priyankan-v/Guitar-Headphone-Amplifier/1.jpg

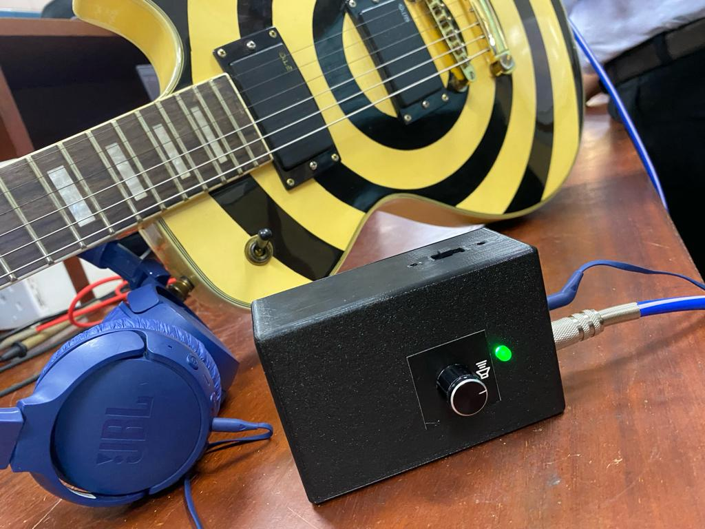
1.jpg
