priyankan-v/Guitar-Headphone-Amplifier/product.jpeg

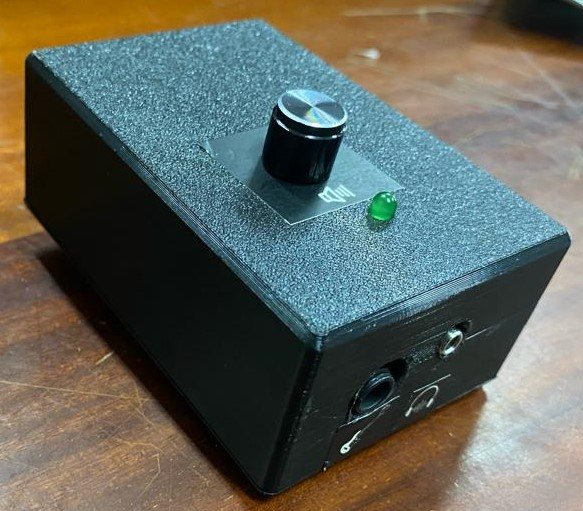
product.jpeg
