priyankan-v/Guitar-Headphone-Amplifier/README.md

# Guitar-Headphone-Amplifier
Designing a headphone amplifier with analog components
