priyankan-v/Guitar-Headphone-Amplifier/BoM.pdf

Comment | Description | Designator | Footprint | LibRef | Quantity
2.2uF | Capacitor Polarised | C1 | CAPPRD200W50D500H 1250 | ESK225M050AC3KA | 1
470uF | Capacitor Polarised | C2 | CAPPRD500W65D1000 H1700 | ECA-1VM471B | 1
47uF | Capacitor Polarised | C3 | CAPPRD500W60D1300 H2200 | UCS2E470MHD1TO | 1
1000uF | Capacitor Polarised | C4 | CAPPRD750W85D1600 H2200 | EEU-FC1V102S | 1
OPA134PA | Dual Low-Noise High-Speed Audio Operational Amplifier, 10 to 30 V, 0 to 70 degC, 8-pin DIP (P8), Pb-Free (RoHS) | IC1 | P0008A | CMP-0017-00910-2 | 1
4833.2330 | Connector | J1 | 48332330 | 4833.2330 | 1
SJ1-3515N | Connector | J2 | SJ13515N | SJ1-3515N | 1
B2B-XH-A | Connector | PC1 | SHDR2W64P0X250_1X 2_740X575X700P | B2B-XH-A | 1
10k | Axial Resistor, 10 KOhm, +/- 1%, 0.25 W, -55 to 155 degC, 2-Pin THD, RoHS, Bulk | R1, R2, R3 | RESA60-630X240 | CMP-1659-00074-2 | 3
560 | Axial Resistor, 10 KOhm, +/- 1%, 0.25 W, -55 to 155 degC, 2-Pin THD, RoHS, Bulk | R4 | RESA60-630X240 | CMP-1659-00074-2 | 1
BC547B | Amplifier Transistor, NPN Silicon, 3-Pin TO-92, Bulk Box | T1 | ONSC-TO-92-3-29-11 | CMP-1048-01467-1 | 1
BC557BG | Amplifier Transistor, PNP Silicon, 3-Pin TO-92, Pb-Free, Bulk Box | T2 | ONSC-TO-92-3-29-11 | CMP-1048-01440-1 | 1
PTV09A-4020F-A504 | Variable Resistor | VR1 | PTV09A4020FA504 | PTV09A-4020F-A504 | 1
