priyankan-v/Guitar-Headphone-Amplifier/2.jpg

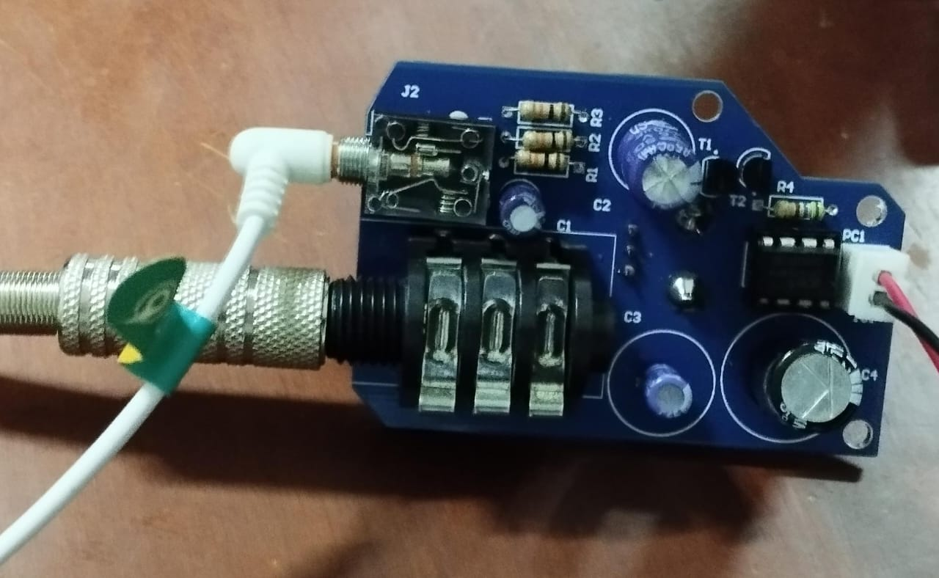
2.jpg
