priyankan-v/Guitar-Headphone-Amplifier/pcb1.png

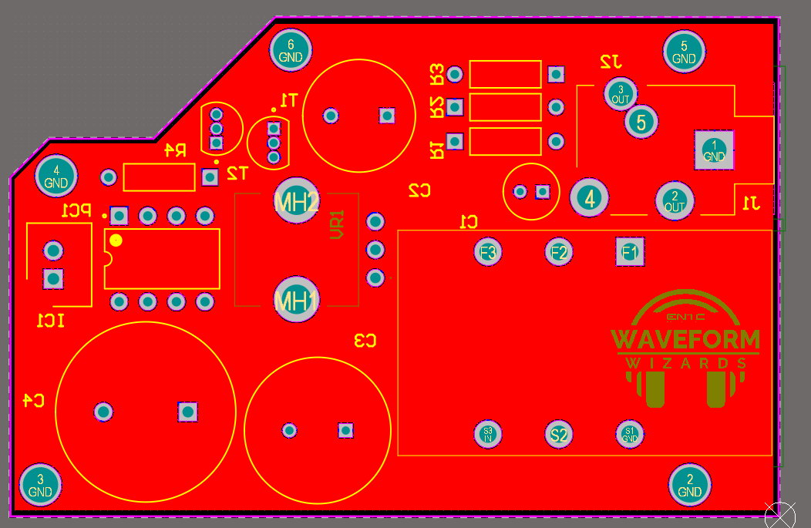
pcb1.png
