priyankan-v/Guitar-Headphone-Amplifier/pcb2.png

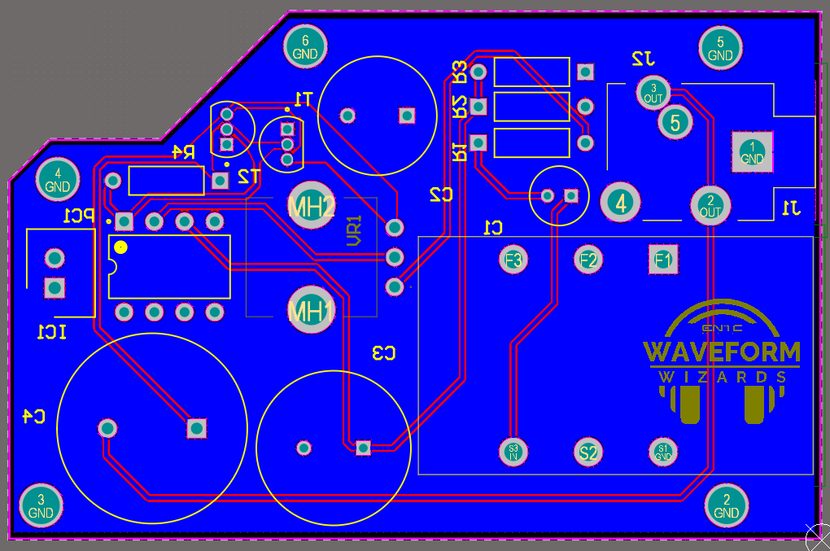
pcb2.png
