priyankan-v/Guitar-Headphone-Amplifier/pcb5.png

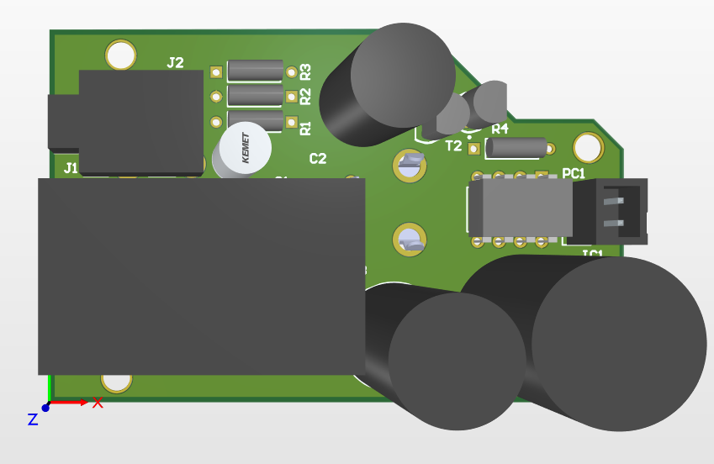
pcb5.png
