priyankan-v/Guitar-Headphone-Amplifier/pcb6.png

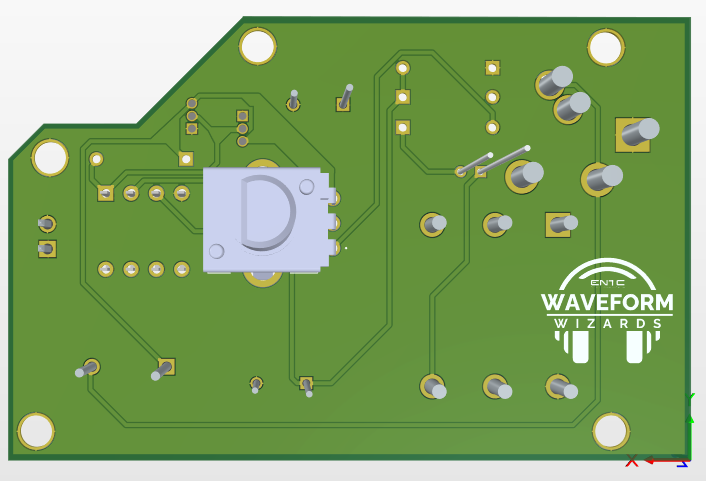
pcb6.png
