priyankan-v/Guitar-Headphone-Amplifier/(list of files, drawings)

Other design files:
Multisim Simulation.ms14
PCB Layout.PcbDoc
PCB Schematic.SchDoc
